Lo20xl/magnetide/design/v21-fusion/cube_front.png

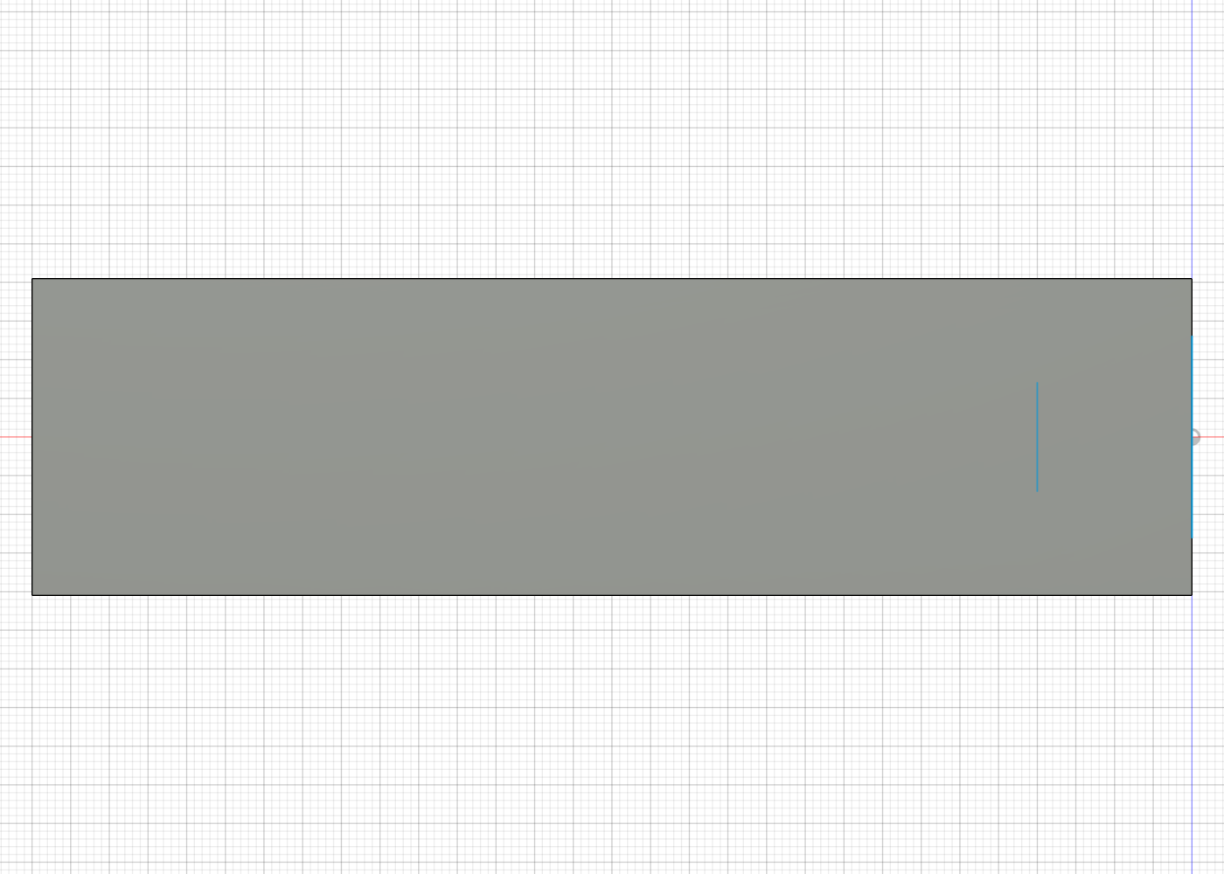
design/v21-fusion/cube_front.png
