Lo20xl/magnetide/design/v21-fusion/cube_iso.png

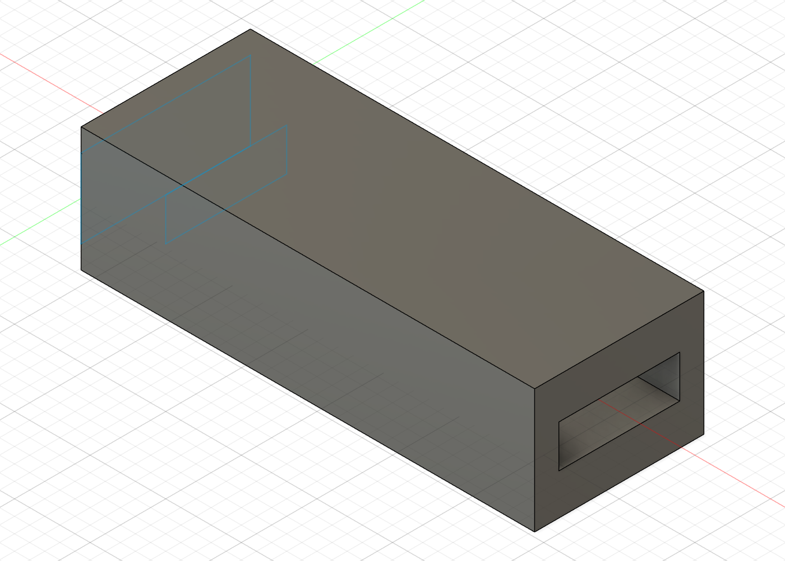
design/v21-fusion/cube_iso.png
