Lo20xl/magnetide/design/v21-fusion/iso_ur_clean.png

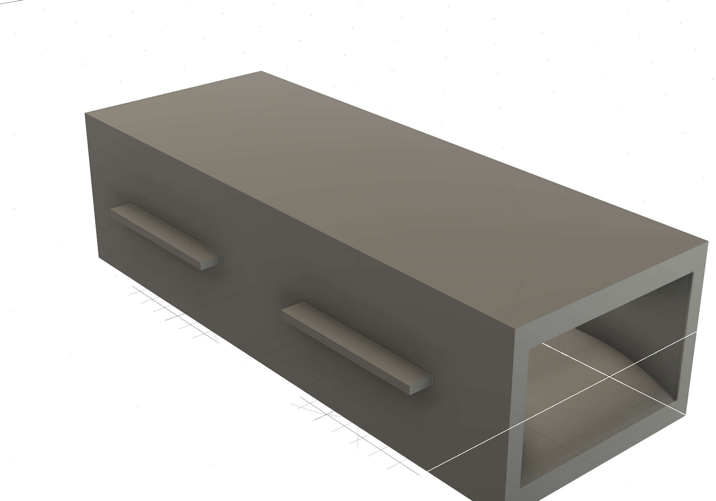
design/v21-fusion/iso_ur_clean.png
