Lo20xl/magnetide/design/v21-fusion/v3_front.png

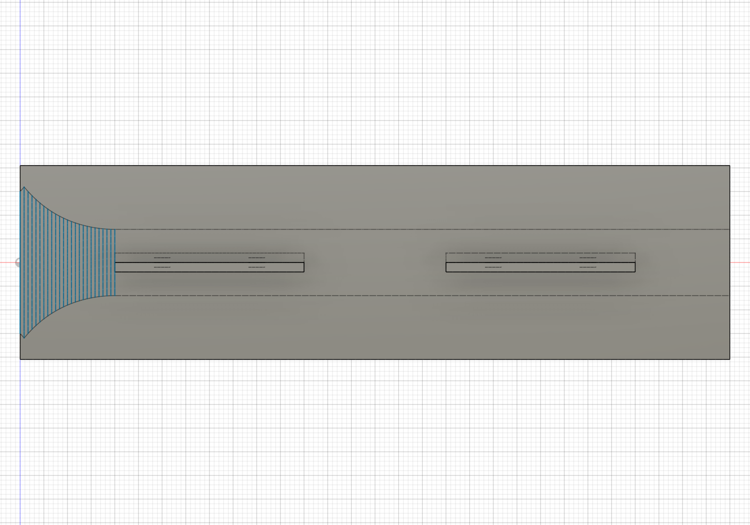
design/v21-fusion/v3_front.png
