Lo20xl/magnetide/design/v21-fusion/v3_iso.png

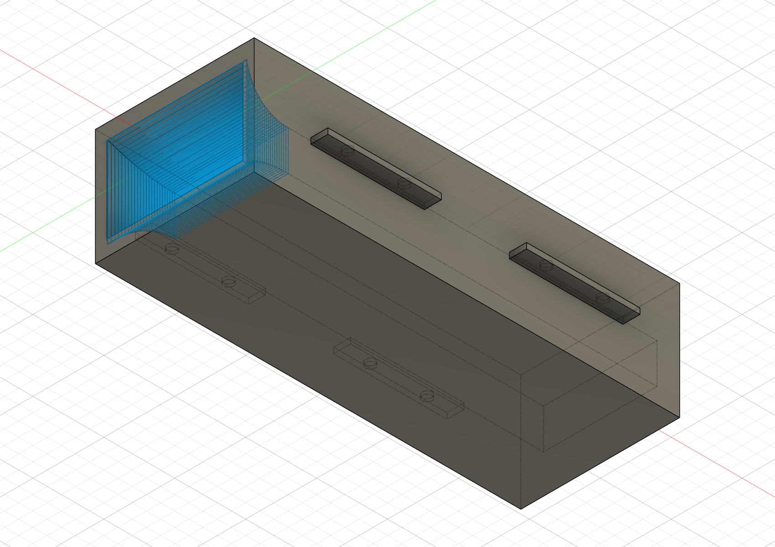
design/v21-fusion/v3_iso.png
