Lo20xl/magnetide/design/v21-fusion/v3_top.png

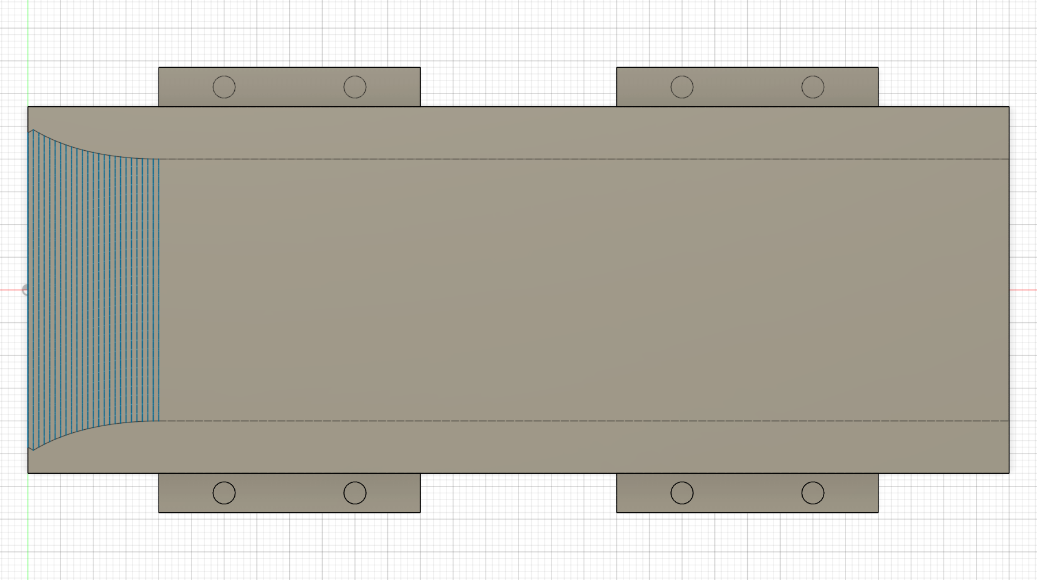
design/v21-fusion/v3_top.png
