Lo20xl/magnetide/design/v21r2/Magnetide-v21r2-crosssection.png

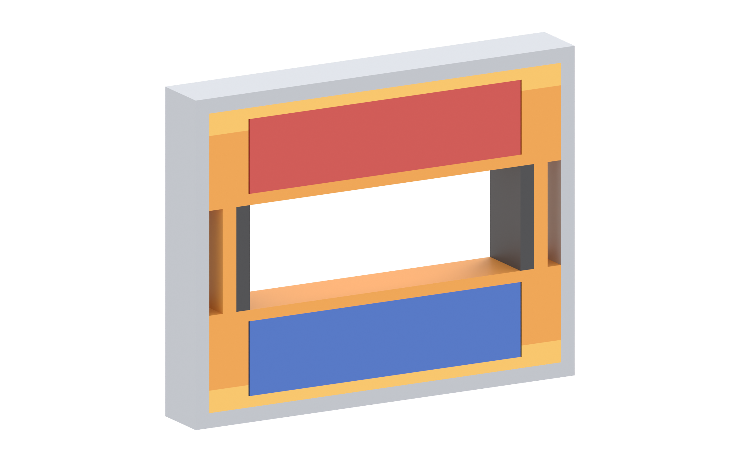
design/v21r2/Magnetide-v21r2-crosssection.png
