Lo20xl/magnetide/design/v21r2/view_r2e_section.png

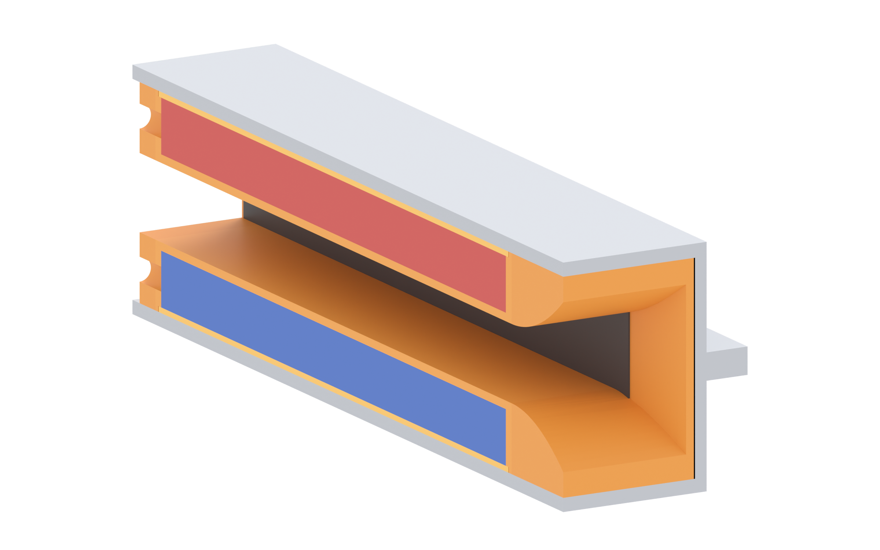
design/v21r2/view_r2e_section.png
