Lo20xl/magnetide/design/v25/v25_closed.png

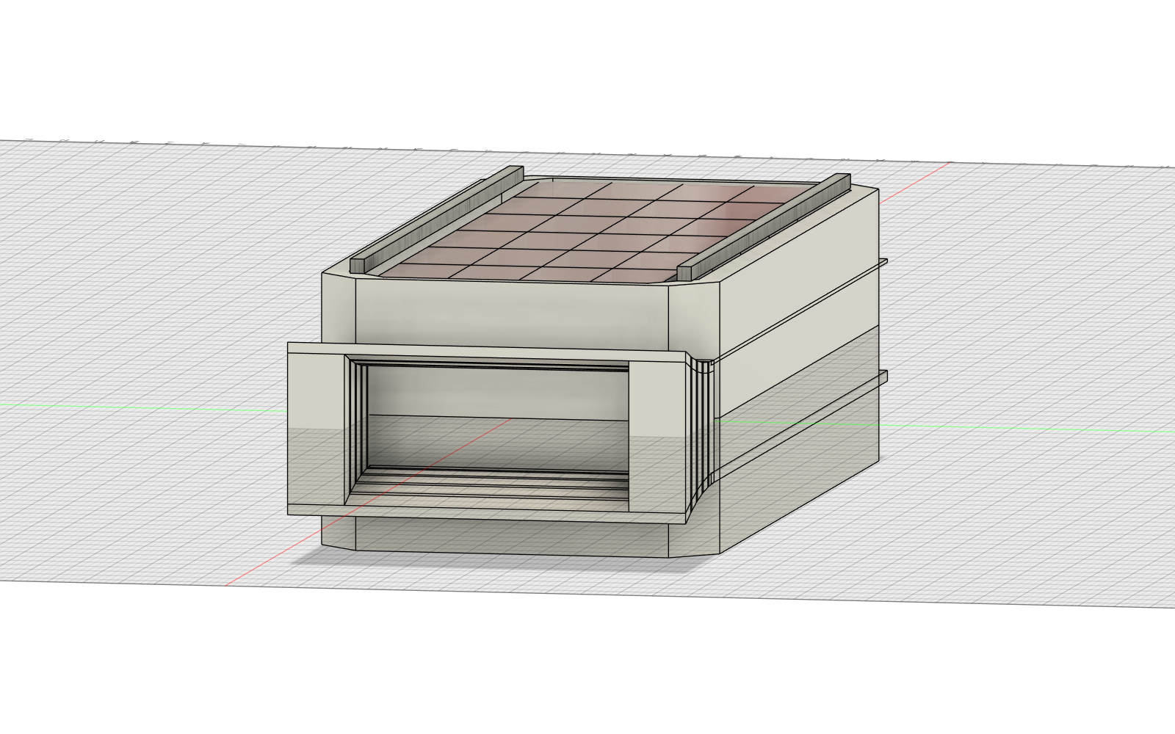
design/v25/v25_closed.png
