Lo20xl/magnetide/design/v25/v25_open.png

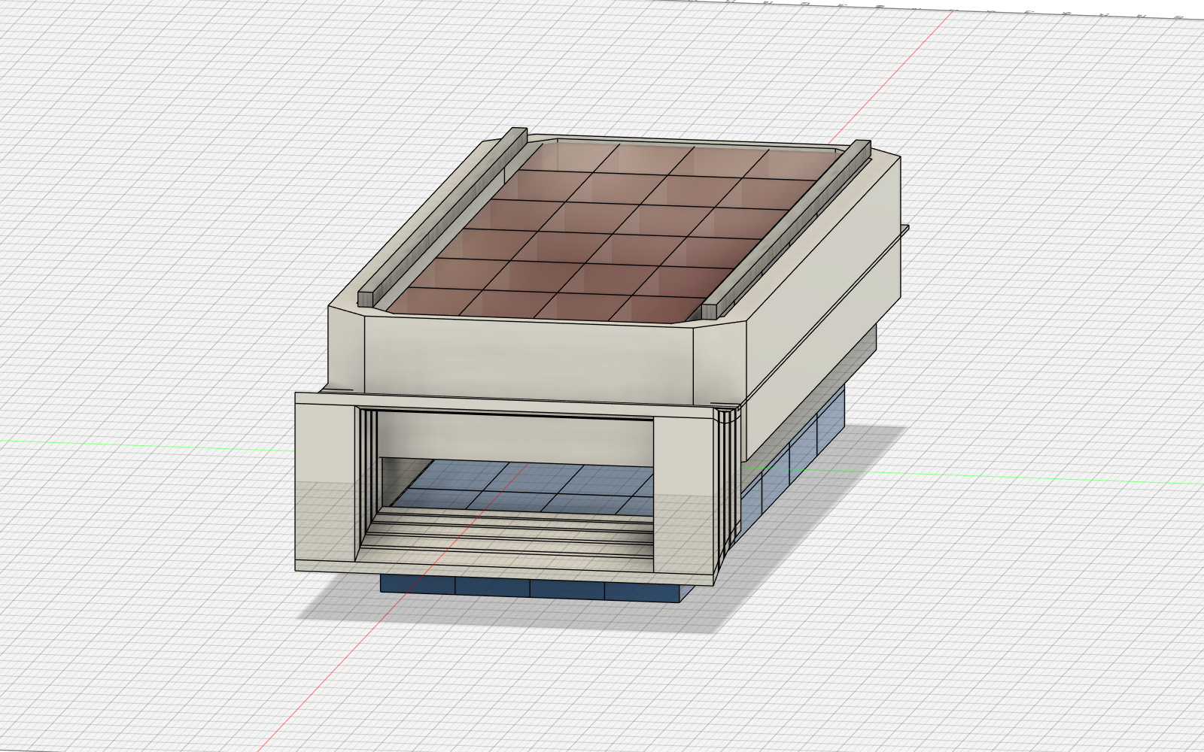
design/v25/v25_open.png
