Lo20xl/magnetide/design/v21-assembly/Magnetide-v21-assembly.step

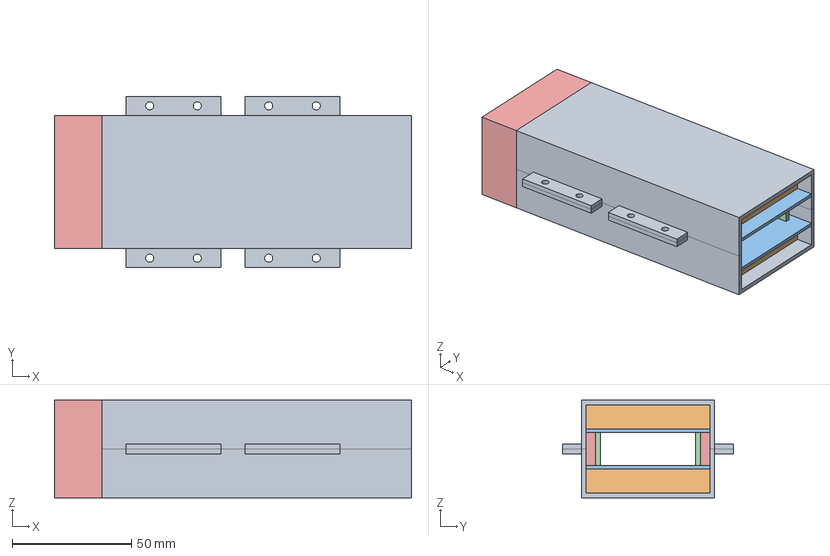
[picture p16: CAD file, 2026-10-23]
design/v21-assembly/Magnetide-v21-assembly.step
150.0 x 72.0 x 41.0 mm
