Lo20xl/magnetide/design/v21r2/release-r2h/Magnetide-v21r2h-assembly.step

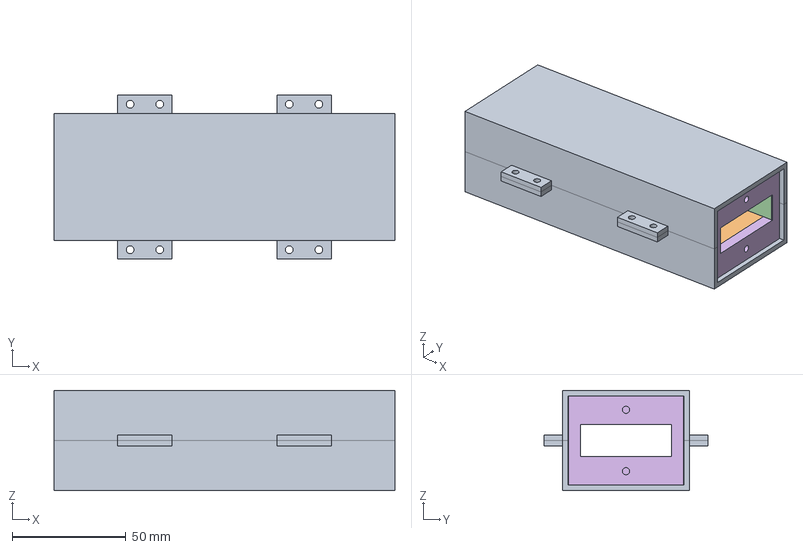
[picture p18: CAD file, 2026-10-23]
design/v21r2/release-r2h/Magnetide-v21r2h-assembly.step
150.0 x 72.0 x 44.0 mm
Steel_Top
Steel_Bottom
Tray_Top
Tray_Bottom
Cap_Top
Cap_Bottom
Electrode_P
Electrode_N
Bellmouth
Rear_Block
MAG_N_0
MAG_N_1
MAG_N_2
MAG_N_3
MAG_S_0
MAG_S_1
MAG_S_2
MAG_S_3
