Lo20xl/magnetide/cfd/case/constant/triSurface/flow.stl

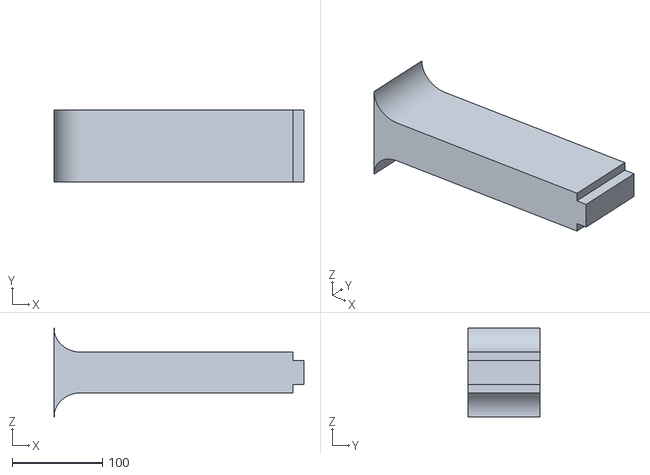
[picture p20: CAD file, 2026-10-20]
cfd/case/constant/triSurface/flow.stl
277.2 x 80.0 x 98.4
