Lo20xl/magnetide/design/v21-assembly/metal/clamshell-flat.dxf

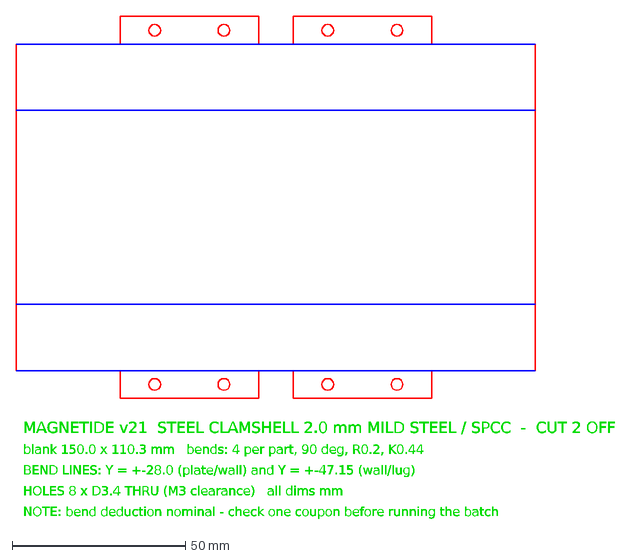
[picture p21: CAD file, 2026-10-23]
design/v21-assembly/metal/clamshell-flat.dxf
MAGNETIDE v21 STEEL CLAMSHELL 2.0 mm MILD STEEL / SPCC - CUT 2 OFF
blank 150.0 x 110.3 mm bends: 4 per part, 90 deg, R0.2, K0.44
BEND LINES: Y = +-28.0 (plate/wall) and Y = +-47.15 (wall/lug)
HOLES 8 x D3.4 THRU (M3 clearance) all dims mm
NOTE: bend deduction nominal - check one coupon before running the batch
