Lo20xl/magnetide/design/v21-assembly/plastic/tray.stl

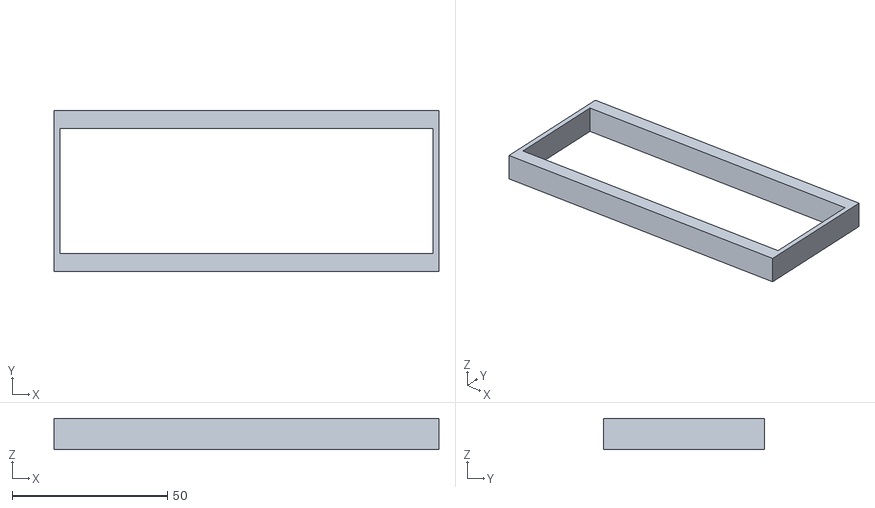
[picture p22: CAD file, 2026-10-23]
design/v21-assembly/plastic/tray.stl
124.0 x 52.0 x 10.0
