Lo20xl/magnetide/design/v21-stl/design-a/printable/rail_right.stl

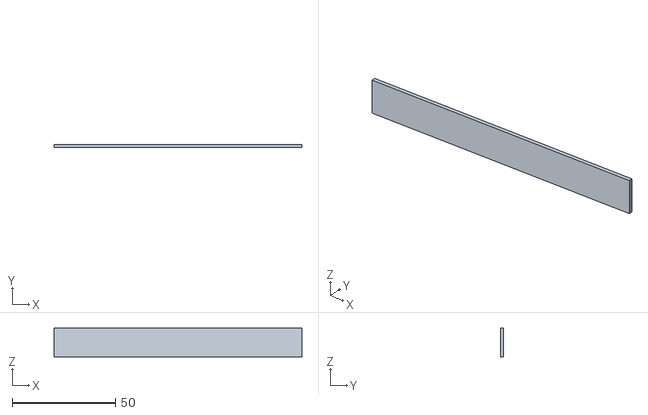
[picture p23: CAD file, 2026-10-21]
design/v21-stl/design-a/printable/rail_right.stl
120.0 x 1.60 x 14.0
