Lo20xl/magnetide/design/v21-stl/design-b/printable/front_flange.stl

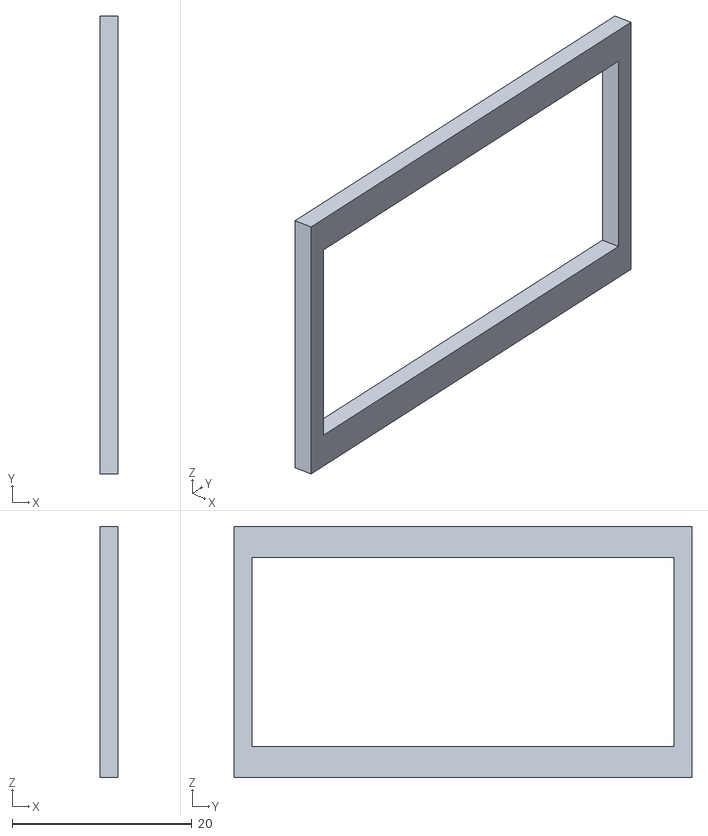
[picture p24: CAD file, 2026-10-21]
design/v21-stl/design-b/printable/front_flange.stl
2.00 x 51.0 x 28.0
