Lo20xl/magnetide/design/v21r2/metal/clamshell-flat-2.5mm.dxf

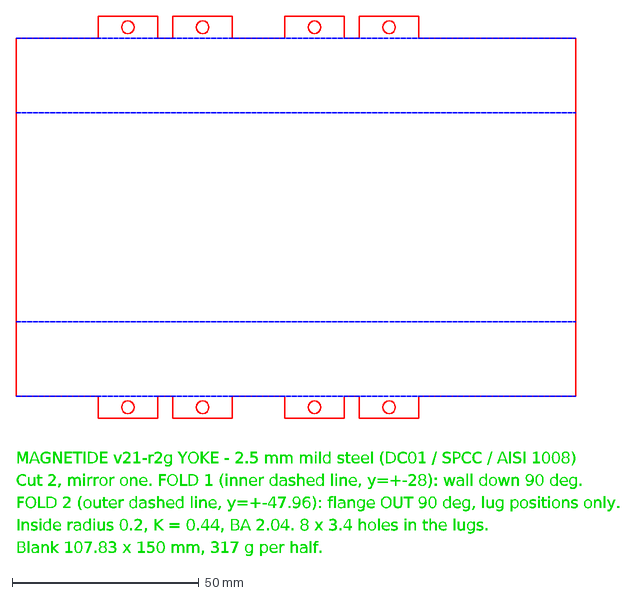
[picture p25: CAD file, 2026-10-23]
design/v21r2/metal/clamshell-flat-2.5mm.dxf
MAGNETIDE v21-r2g YOKE - 2.5 mm mild steel (DC01 / SPCC / AISI 1008)
Cut 2, mirror one. FOLD 1 (inner dashed line, y=+-28): wall down 90 deg.
FOLD 2 (outer dashed line, y=+-47.96): flange OUT 90 deg, lug positions only.
Inside radius 0.2, K = 0.44, BA 2.04. 8 x 3.4 holes in the lugs.
Blank 107.83 x 150 mm, 317 g per half.
