Lo20xl/magnetide/design/v21r2/release-r2h/laser/clamshell-flat-2.5mm.dxf

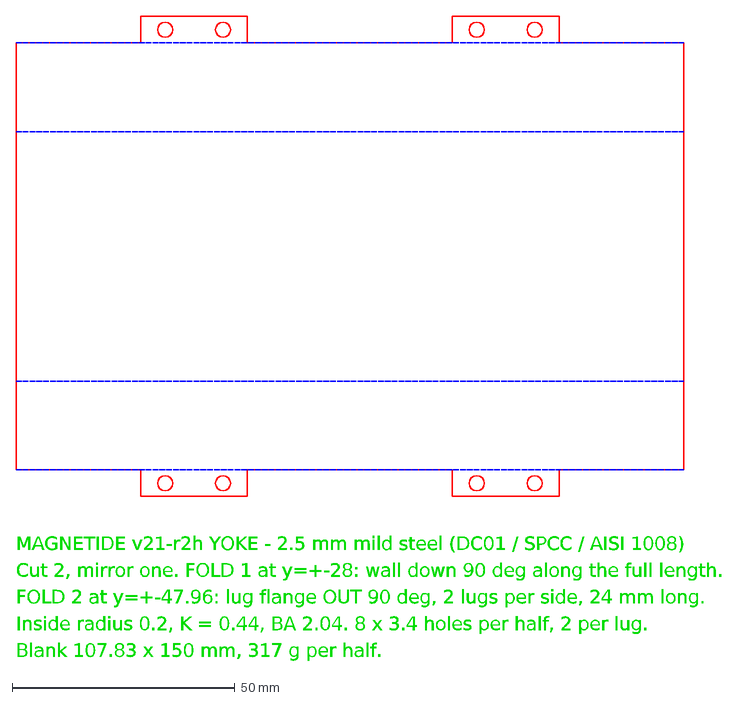
[picture p26: CAD file, 2026-10-23]
design/v21r2/release-r2h/laser/clamshell-flat-2.5mm.dxf
MAGNETIDE v21-r2h YOKE - 2.5 mm mild steel (DC01 / SPCC / AISI 1008)
Cut 2, mirror one. FOLD 1 at y=+-28: wall down 90 deg along the full length.
FOLD 2 at y=+-47.96: lug flange OUT 90 deg, 2 lugs per side, 24 mm long.
Inside radius 0.2, K = 0.44, BA 2.04. 8 x 3.4 holes per half, 2 per lug.
Blank 107.83 x 150 mm, 317 g per half.
