Lo20xl/magnetide/design/v21r2/release-r2h/print/bellmouth.stl

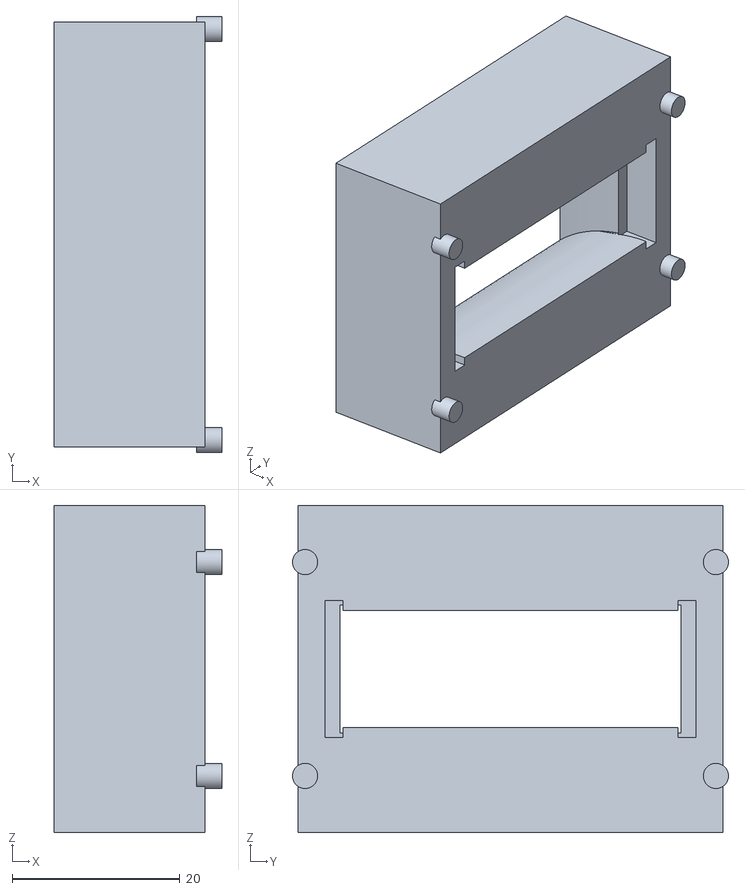
[picture p27: CAD file, 2026-10-23]
design/v21r2/release-r2h/print/bellmouth.stl
20.0 x 52.0 x 39.0
