Lo20xl/magnetide/design/v21r2/release-r2i/laser/clamshell-flat-3.0mm.dxf

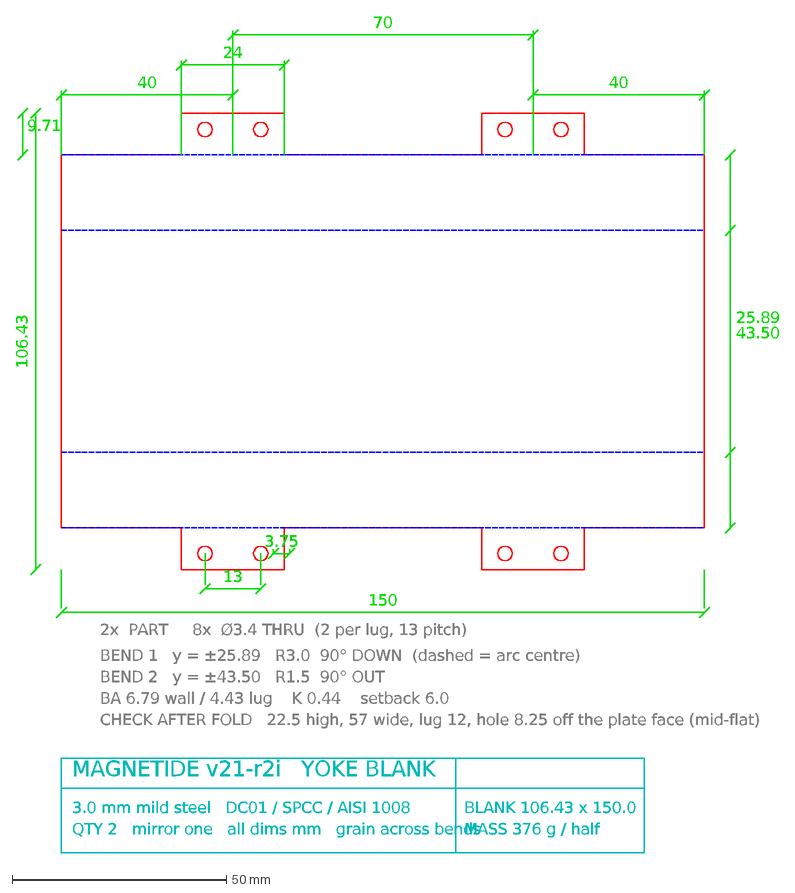
[picture p28: CAD file, 2026-10-24]
design/v21r2/release-r2i/laser/clamshell-flat-3.0mm.dxf
150
13
3.75
43.50
25.89
106.43
40
24
70
9.71
2x PART 8x Ø3.4 THRU (2 per lug, 13 pitch)
BEND 1 y = ±25.89 R3.0 90° DOWN (dashed = arc centre)
BEND 2 y = ±43.50 R1.5 90° OUT
BA 6.79 wall / 4.43 lug K 0.44 setback 6.0
CHECK AFTER FOLD 22.5 high, 57 wide, lug 12, hole 8.25 off the plate face (mid-flat)
MAGNETIDE v21-r2i YOKE BLANK
3.0 mm mild steel DC01 / SPCC / AISI 1008
QTY 2 mirror one all dims mm grain across bends
BLANK 106.43 x 150.0
MASS 376 g / half
