Lo20xl/magnetide/design/v21r2/release-r2i/print/cap.stl

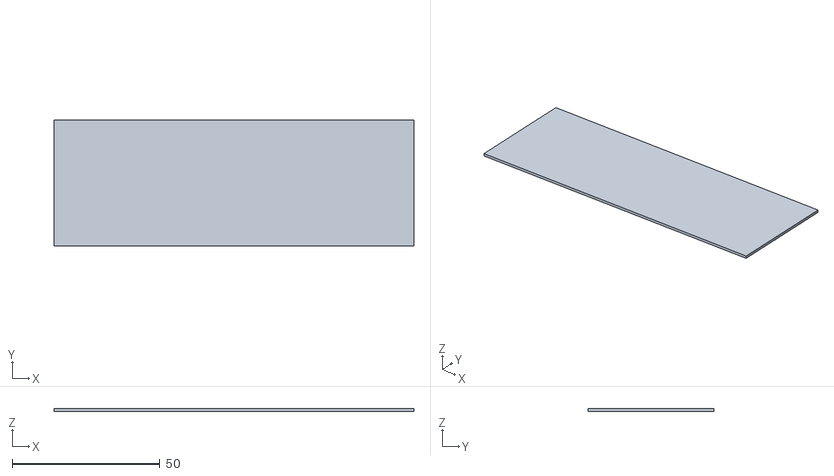
[picture p29: CAD file, 2026-10-24]
design/v21r2/release-r2i/print/cap.stl
121.7 x 42.7 x 1.00
