Lo20xl/magnetide/design/v21r2/release-r2i/yoke-steel-top.step

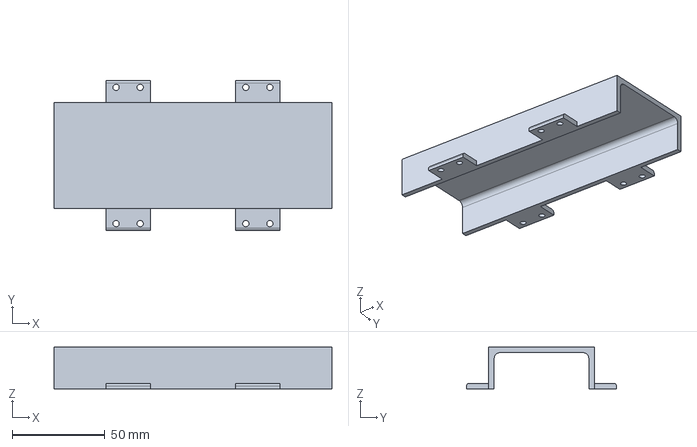
[picture p30: CAD file, 2026-10-24]
design/v21r2/release-r2i/yoke-steel-top.step
150.0 x 81.0 x 22.5 mm
