Lo20xl/magnetide/stl/nozzle_plate_mild_56x27.stl

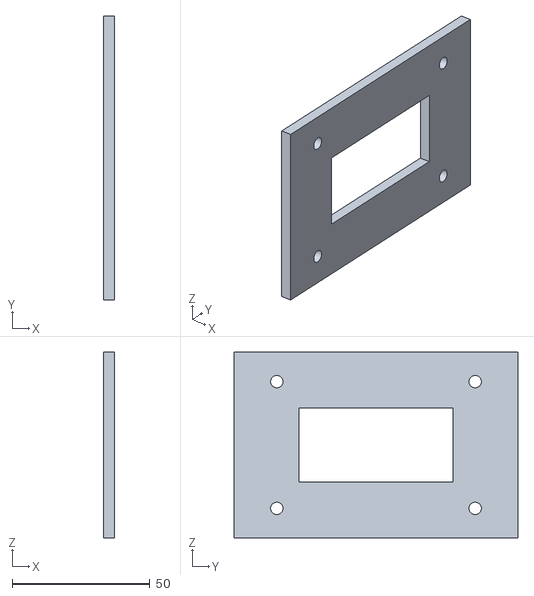
[picture p31: CAD file, 2026-10-20]
stl/nozzle_plate_mild_56x27.stl
4.00 x 103.0 x 67.5
