Lo20xl/magnetide/design/v21-assembly/plastic/liner_top.stl

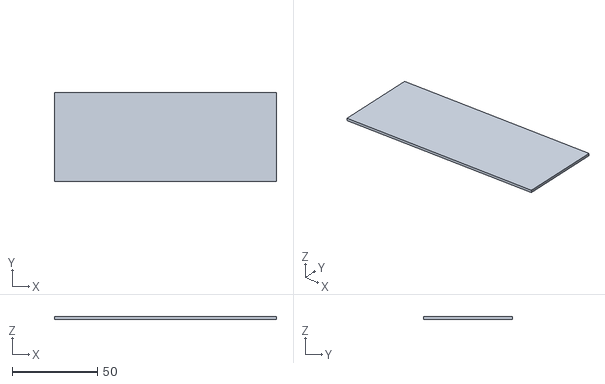
[picture p32: CAD file, 2026-10-23]
design/v21-assembly/plastic/liner_top.stl
130.0 x 52.0 x 1.50
