Lo20xl/magnetide/design/v21-stl/design-b/printable/fairing_bottom.stl

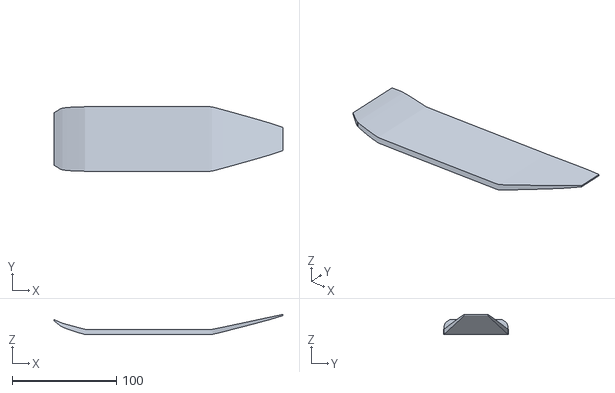
[picture p33: CAD file, 2026-10-21]
design/v21-stl/design-b/printable/fairing_bottom.stl
220.0 x 62.0 x 19.5
