Lo20xl/magnetide/design/v21r2/metal/clamshell-flat.dxf

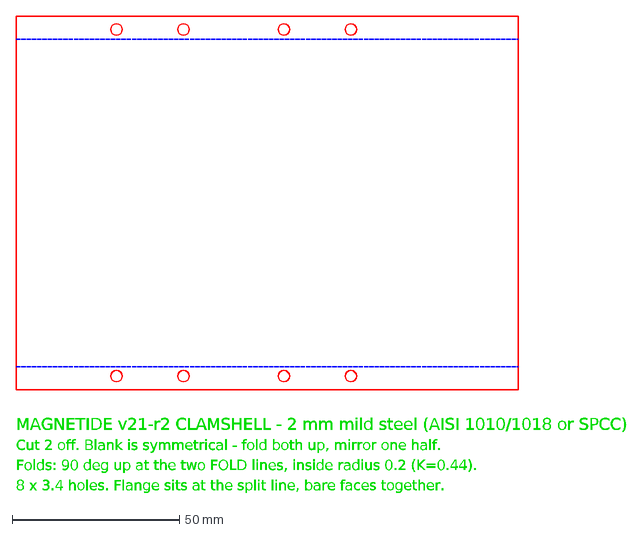
[picture p34: CAD file, 2026-10-23]
design/v21r2/metal/clamshell-flat.dxf
MAGNETIDE v21-r2 CLAMSHELL - 2 mm mild steel (AISI 1010/1018 or SPCC)
Cut 2 off. Blank is symmetrical - fold both up, mirror one half.
Folds: 90 deg up at the two FOLD lines, inside radius 0.2 (K=0.44).
8 x 3.4 holes. Flange sits at the split line, bare faces together.
