Lo20xl/magnetide/design/v21r2/release-r2h/print/rear_block.stl

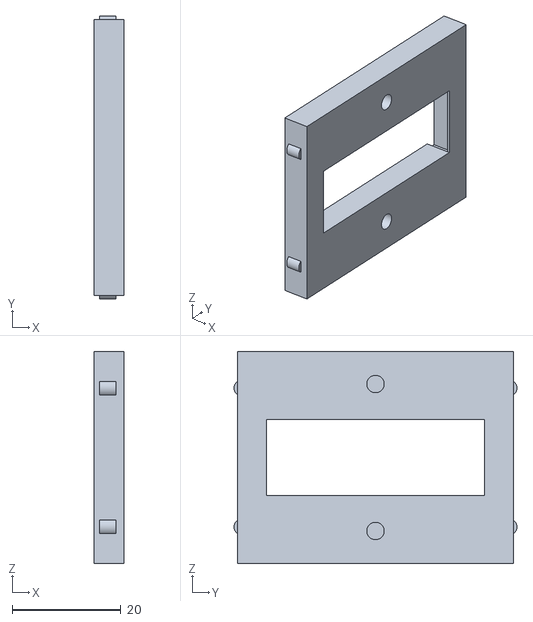
[picture p35: CAD file, 2026-10-23]
design/v21r2/release-r2h/print/rear_block.stl
5.50 x 52.0 x 39.0
