Lo20xl/magnetide/design/v21r2/release-r2i/print/tray.stl

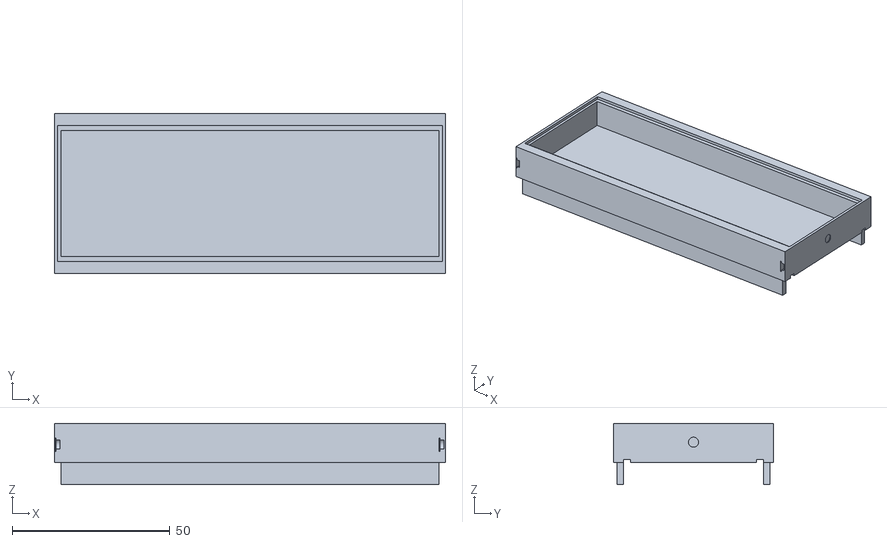
[picture p36: CAD file, 2026-10-24]
design/v21r2/release-r2i/print/tray.stl
124.0 x 50.7 x 19.5
