Lo20xl/magnetide/stl/inlet_cheek_right.stl

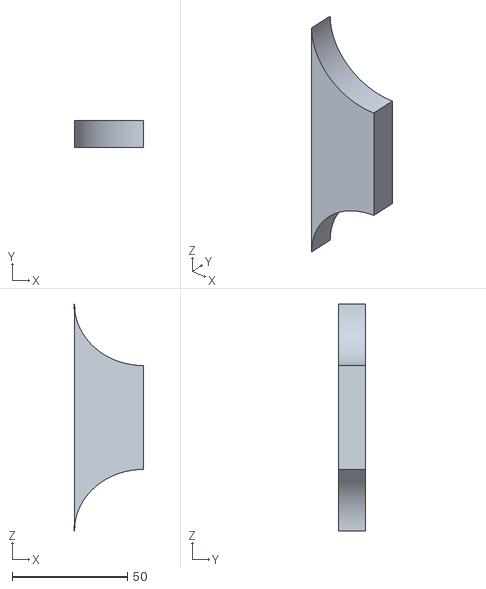
[picture p37: CAD file, 2026-10-20]
stl/inlet_cheek_right.stl
30.0 x 11.5 x 98.4
