Lo20xl/magnetide/design/v21-stl/design-b/printable/plate_b.stl

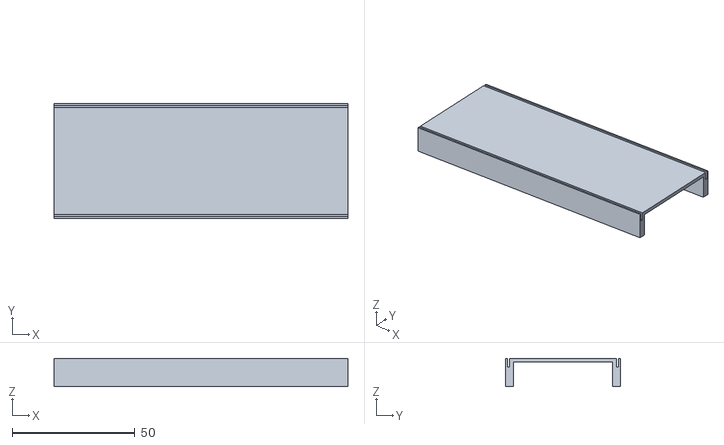
[picture p38: CAD file, 2026-10-21]
design/v21-stl/design-b/printable/plate_b.stl
120.0 x 47.0 x 11.5
