Lo20xl/magnetide/design/v21r2/release-r2i/print/rear_block.stl

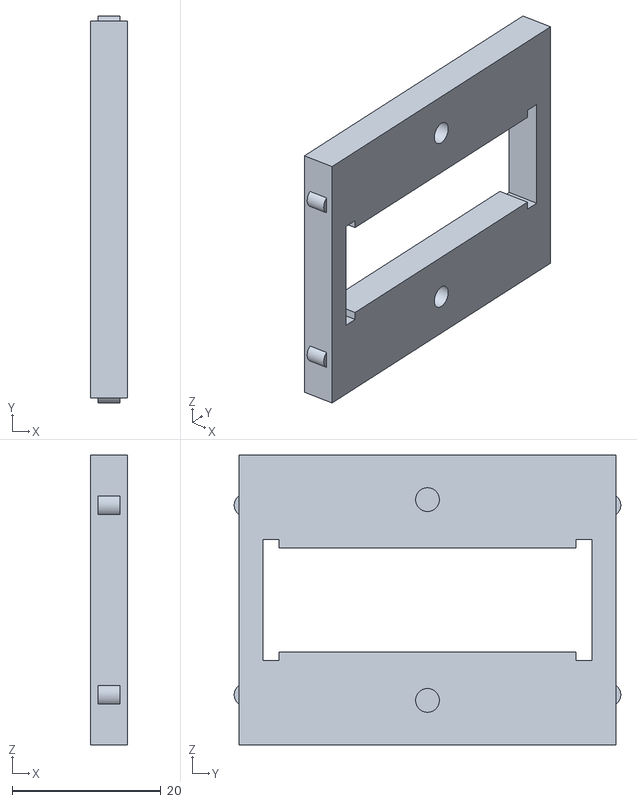
[picture p39: CAD file, 2026-10-24]
design/v21r2/release-r2i/print/rear_block.stl
5.00 x 52.0 x 39.0
