Lo20xl/magnetide/stl/lead_gland_right.stl

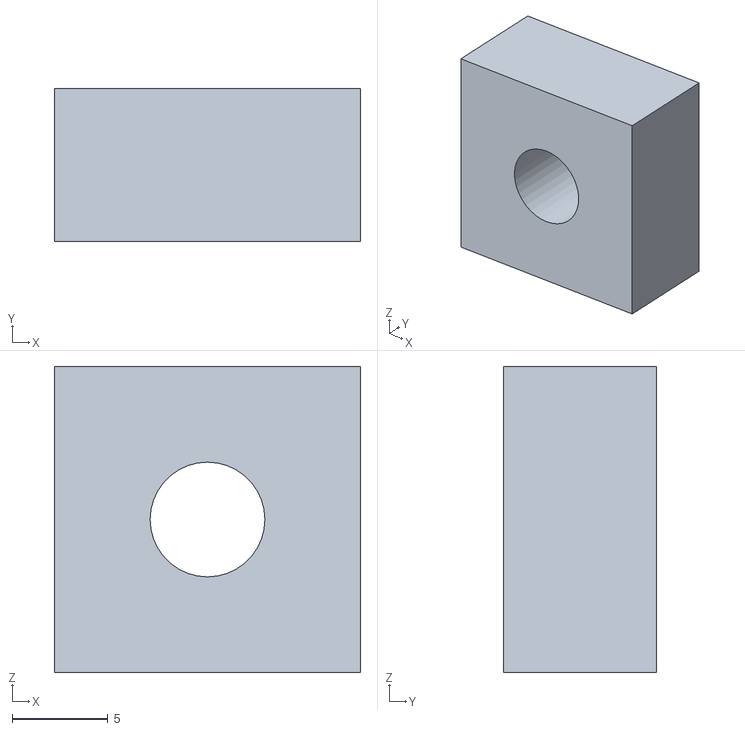
[picture p40: CAD file, 2026-10-20]
stl/lead_gland_right.stl
16.0 x 8.00 x 16.0
