Lo20xl/magnetide/design/v21-assembly/plastic/bellmouth.stl

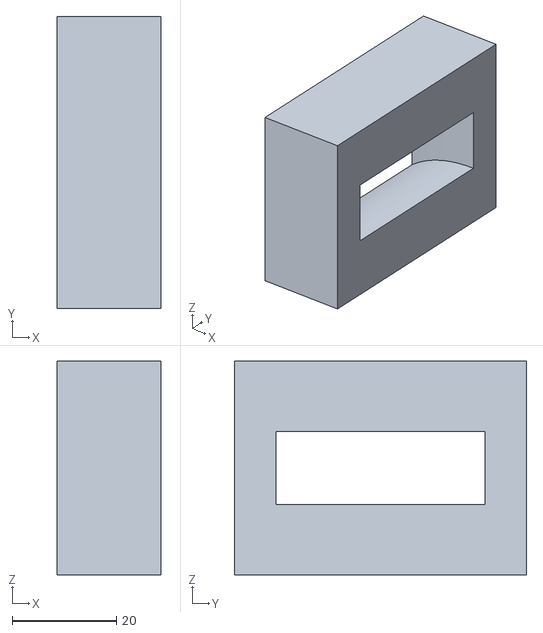
[picture p41: CAD file, 2026-10-23]
design/v21-assembly/plastic/bellmouth.stl
20.0 x 56.0 x 41.0
