Lo20xl/magnetide/design/v21-stl/design-b/printable/bellmouth_top.stl

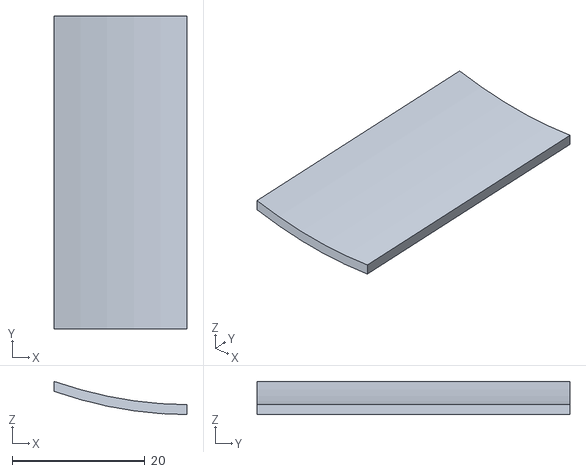
[picture p42: CAD file, 2026-10-21]
design/v21-stl/design-b/printable/bellmouth_top.stl
20.0 x 47.0 x 5.00
