Lo20xl/magnetide/design/v21r2/plastic/bellmouth.stl

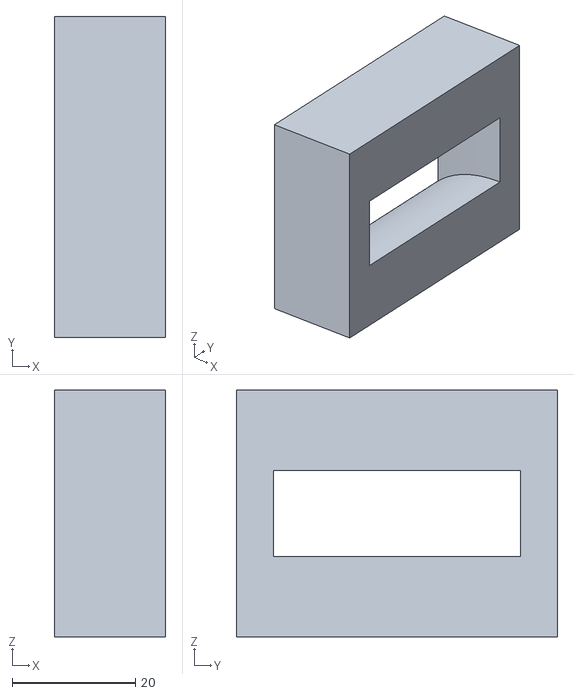
[picture p43: CAD file, 2026-10-23]
design/v21r2/plastic/bellmouth.stl
18.0 x 52.0 x 40.0
