Lo20xl/magnetide/stl/magnet_tray_top_rim.stl

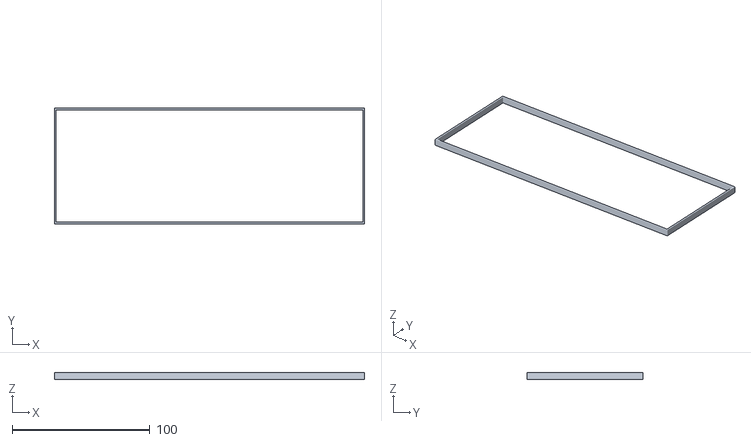
[picture p44: CAD file, 2026-10-20]
stl/magnet_tray_top_rim.stl
225.2 x 84.0 x 5.05
