Lo20xl/magnetide/design/v21-stl/design-b/printable/rear_cap.stl

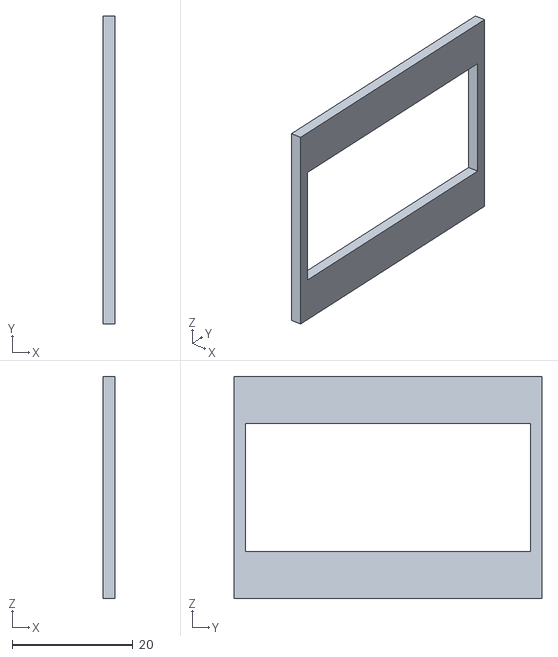
[picture p45: CAD file, 2026-10-21]
design/v21-stl/design-b/printable/rear_cap.stl
2.00 x 51.0 x 36.8
