Lo20xl/magnetide/stl/housing_shell_side_left_aft.stl

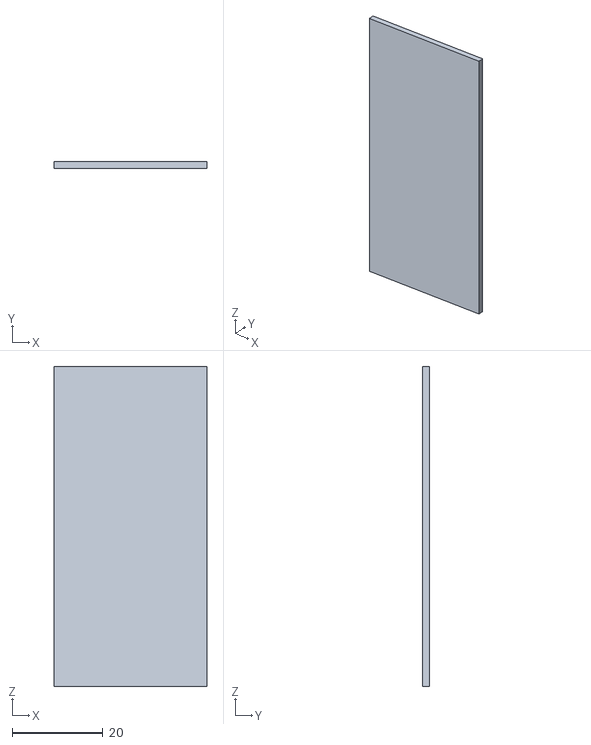
[picture p46: CAD file, 2026-10-20]
stl/housing_shell_side_left_aft.stl
33.6 x 1.50 x 70.5
