Lo20xl/magnetide/design/v21-stl/design-b/printable/bellmouth_right.stl

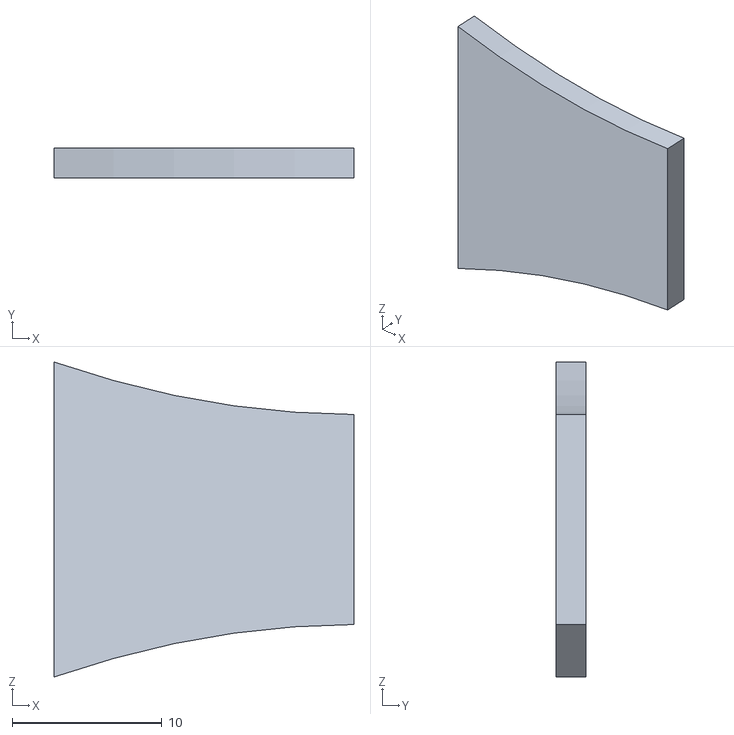
[picture p47: CAD file, 2026-10-21]
design/v21-stl/design-b/printable/bellmouth_right.stl
20.0 x 2.00 x 21.0
