Lo20xl/magnetide/stl/housing_shell_side_right_under.stl

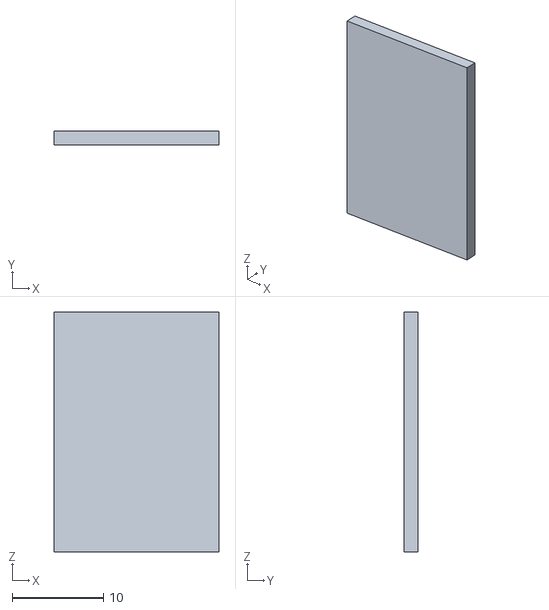
[picture p48: CAD file, 2026-10-20]
stl/housing_shell_side_right_under.stl
18.0 x 1.50 x 26.2
