Lo20xl/magnetide/stl/inlet_flare_top.stl

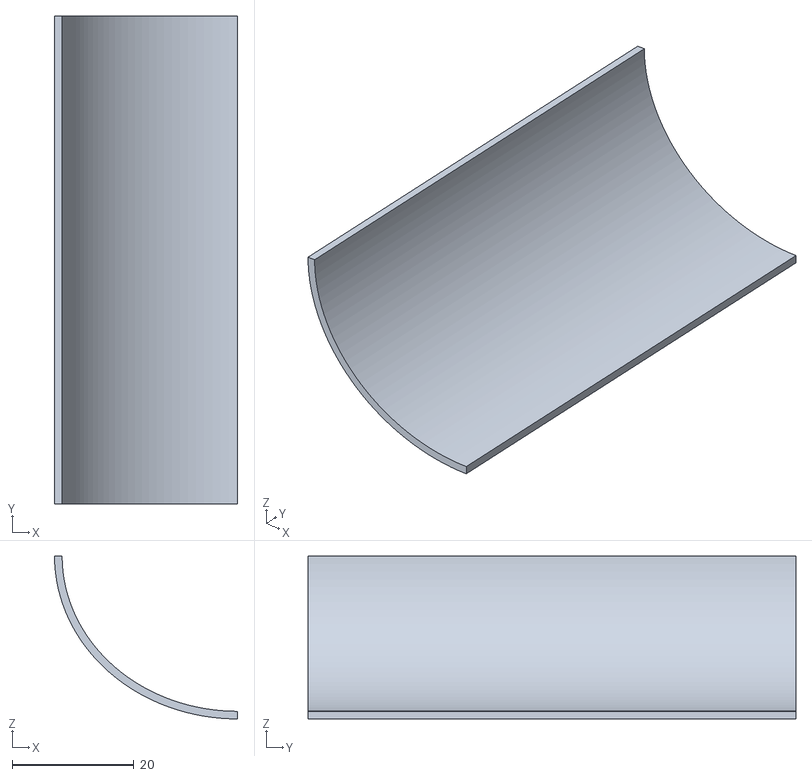
[picture p49: CAD file, 2026-10-20]
stl/inlet_flare_top.stl
30.0 x 80.0 x 26.7
