Lo20xl/magnetide/design/v21-stl/design-b/printable/fair_tail_bulkhead.stl

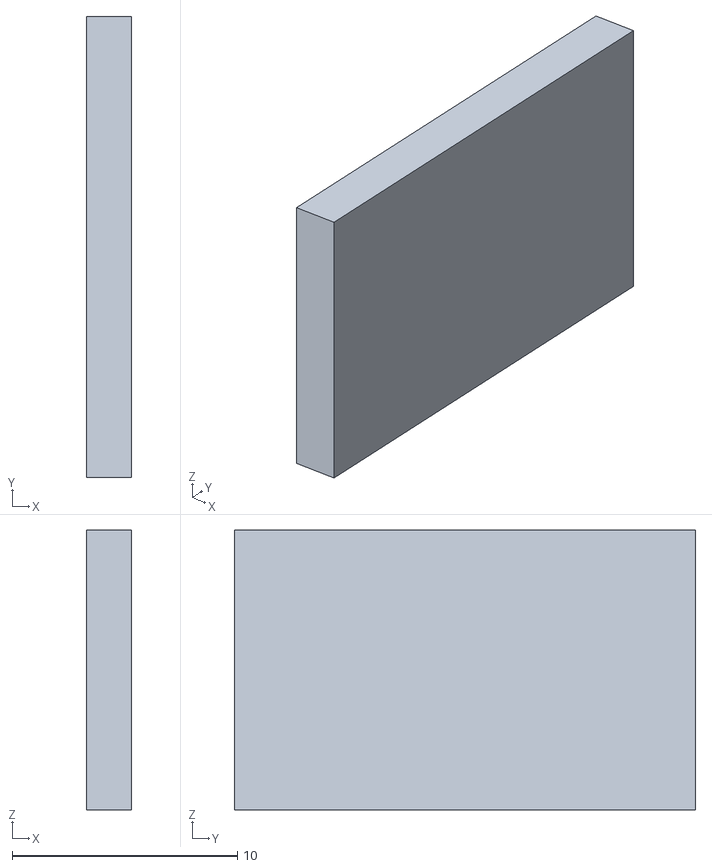
[picture p50: CAD file, 2026-10-21]
design/v21-stl/design-b/printable/fair_tail_bulkhead.stl
2.00 x 20.5 x 12.4
