Lo20xl/magnetide/stl/mount_flange_inlet.stl

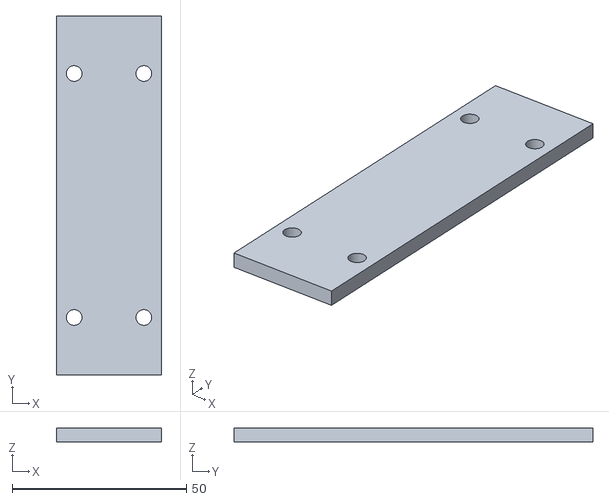
[picture p51: CAD file, 2026-10-20]
stl/mount_flange_inlet.stl
30.0 x 103.0 x 4.00
