Lo20xl/magnetide/design/v21-stl/design-b/printable/fairing_left.stl

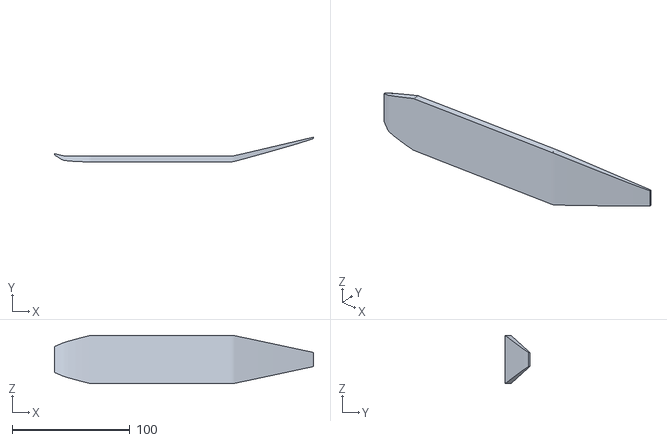
[picture p52: CAD file, 2026-10-21]
design/v21-stl/design-b/printable/fairing_left.stl
220.0 x 21.0 x 41.0
