Lo20xl/magnetide/stl/housing_shell_side_right_fwd.stl

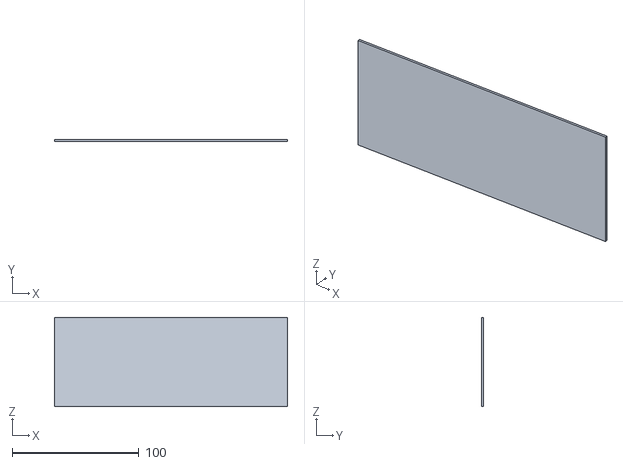
[picture p53: CAD file, 2026-10-20]
stl/housing_shell_side_right_fwd.stl
183.6 x 1.50 x 70.5
