Lo20xl/magnetide/stl/housing_shell_top_mid.stl

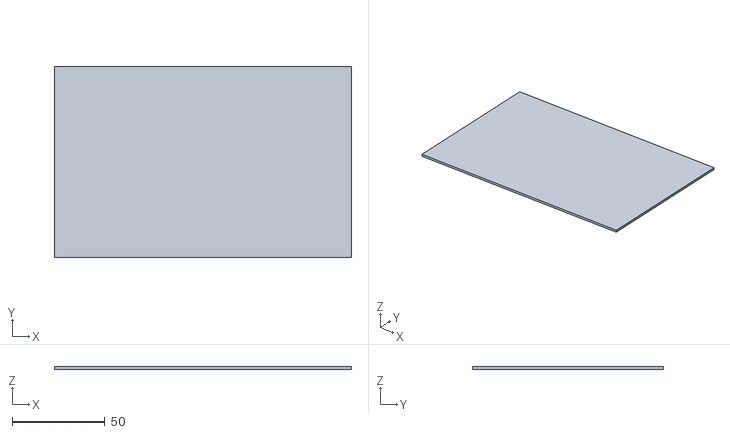
[picture p54: CAD file, 2026-10-20]
stl/housing_shell_top_mid.stl
160.0 x 103.0 x 1.50
