Lo20xl/magnetide/design/v21-stl/design-b/printable/fair_nose_bulkhead.stl

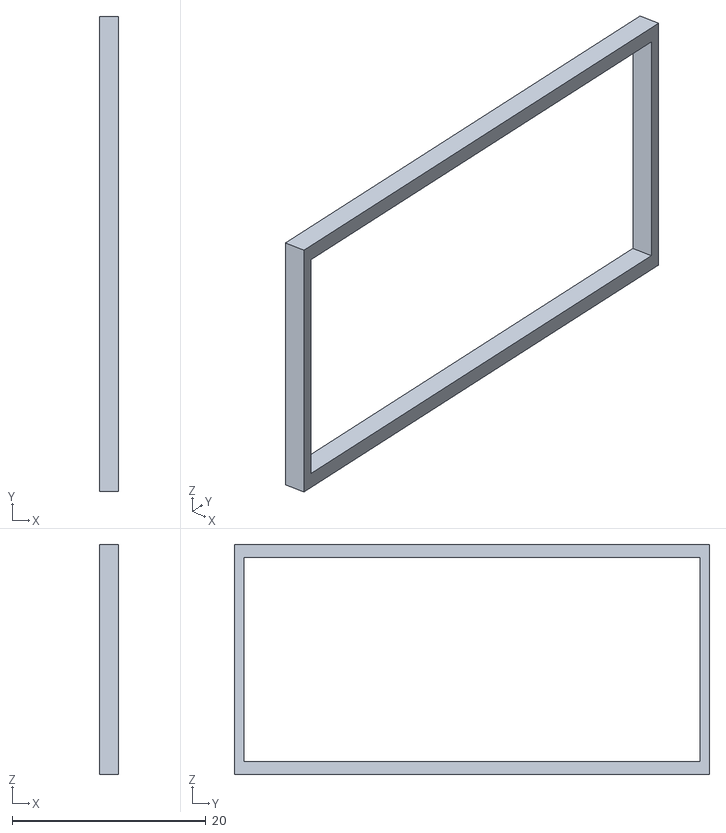
[picture p55: CAD file, 2026-10-21]
design/v21-stl/design-b/printable/fair_nose_bulkhead.stl
2.00 x 49.0 x 23.8
