Lo20xl/magnetide/stl/housing_shell_cap_outlet.stl

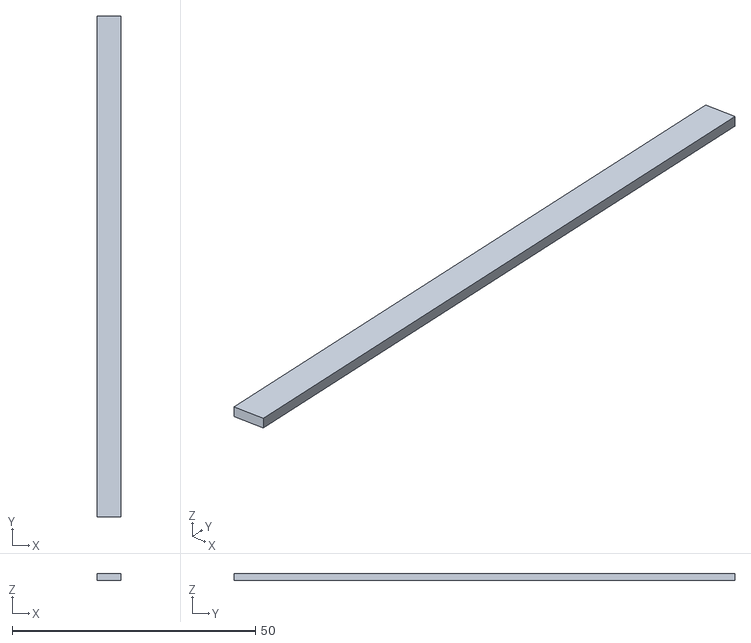
[picture p56: CAD file, 2026-10-20]
stl/housing_shell_cap_outlet.stl
5.00 x 103.0 x 1.50
