Lo20xl/magnetide/stl/magnet_tray_top_floor.stl

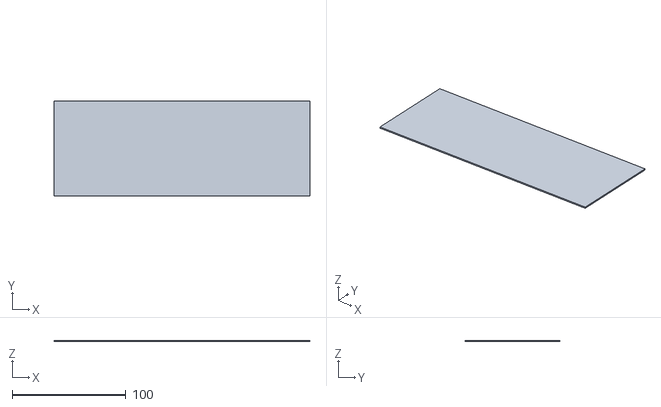
[picture p57: CAD file, 2026-10-20]
stl/magnet_tray_top_floor.stl
225.2 x 84.0 x 1.20
