Lo20xl/magnetide/(list of files, cad)

Other CAD files:
design/v21r2/Magnetide-v21r2e-assembly.step
design/v21r2/Magnetide-v21r2-assembly.step
design/v21r2/release-r2i/yoke-steel-bottom.step
design/v21-assembly/plastic/liner_bottom.stl
design/v21-stl/design-b/printable/rail_left.stl
design/v21-stl/design-b/printable/bellmouth_left.stl
stl/housing_shell_side_left_over.stl
design/v21-stl/design-b/printable/bellmouth_bottom.stl
stl/lead_gland_left.stl
design/v21-stl/design-b/printable/fairing_right.stl
design/v21-stl/design-b/printable/fairing_top.stl
stl/magnet_tray_bottom_rim.stl
design/v21-stl/design-b/printable/plate_a.stl
stl/inlet_cheek_left.stl
stl/housing_shell_cap_inlet.stl
stl/housing_shell_side_right_aft.stl
stl/housing_shell_side_left_fwd.stl
stl/mount_flange_outlet.stl
stl/inlet_flare_bottom.stl
stl/housing_shell_side_left_under.stl
stl/housing_shell_side_right_over.stl
stl/magnet_tray_bottom_floor.stl
design/v21-assembly/Magnetide-v21-EXPLODED.f3d
design/v21-assembly/Magnetide-v21-assembly.f3d
design/v21-fusion/Magnetide-v21-cube.f3d
design/v21-stl/design-a/Magnetide-A-full.f3d
design/v21-stl/design-a/Magnetide-A-printable.f3d
design/v21-stl/design-b/Magnetide-B-full.f3d
design/v21-stl/design-b/Magnetide-B-printable.f3d
design/v21r2/Magnetide-v21r2-EXPLODED.f3d
design/v21r2/Magnetide-v21r2-assembly.f3d
design/v21r2/Magnetide-v21r2e-EXPLODED.f3d
design/v21r2/Magnetide-v21r2e-assembly.f3d
design/v21r2/Magnetide-v21r2g-assembly.f3d
design/v21r2/plastic/cap.stl
design/v21r2/plastic/rear_block.stl
design/v21r2/plastic/tray.stl
design/v21r2/release-r2h/Magnetide-v21r2h-EXPLODED.f3d
design/v21r2/release-r2h/Magnetide-v21r2h-assembly.f3d
design/v22-casing.f3d
design/v23/Magnetide-v23-full.f3d
design/v23/graphite_L.stl
design/v23/graphite_R.stl
design/v23/half.stl
