Lo20xl/magnetide/design/v21-assembly/Magnetide-v21-exploded-fusion-below.png

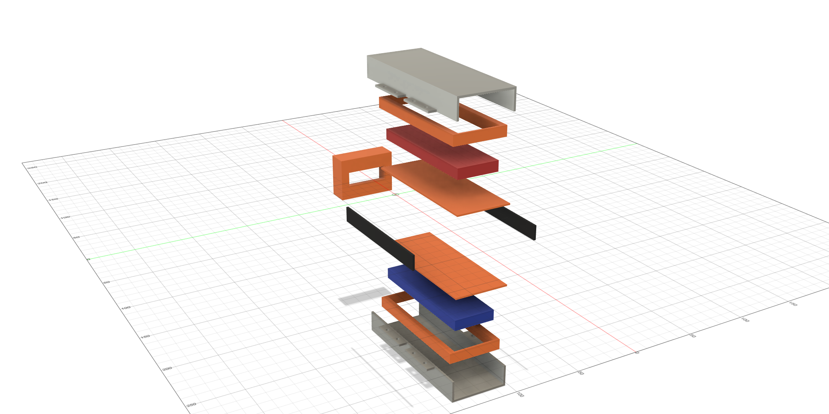
design/v21-assembly/Magnetide-v21-exploded-fusion-below.png
