Lo20xl/magnetide/design/v21-assembly/Magnetide-v21-exploded-view.png

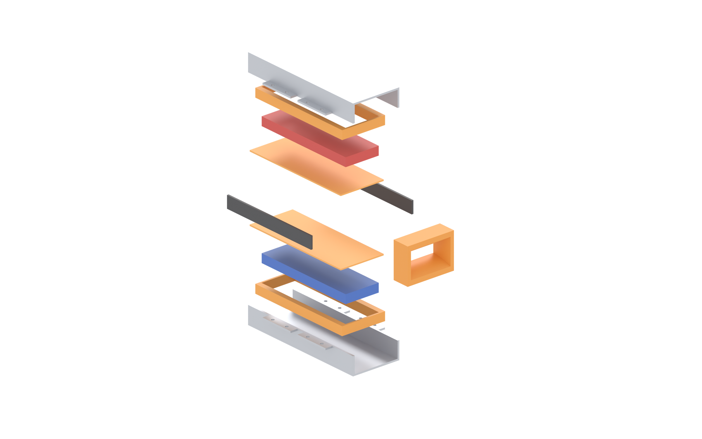
design/v21-assembly/Magnetide-v21-exploded-view.png
