Lo20xl/magnetide/design/v21-assembly/metal/clamshell-flat.png

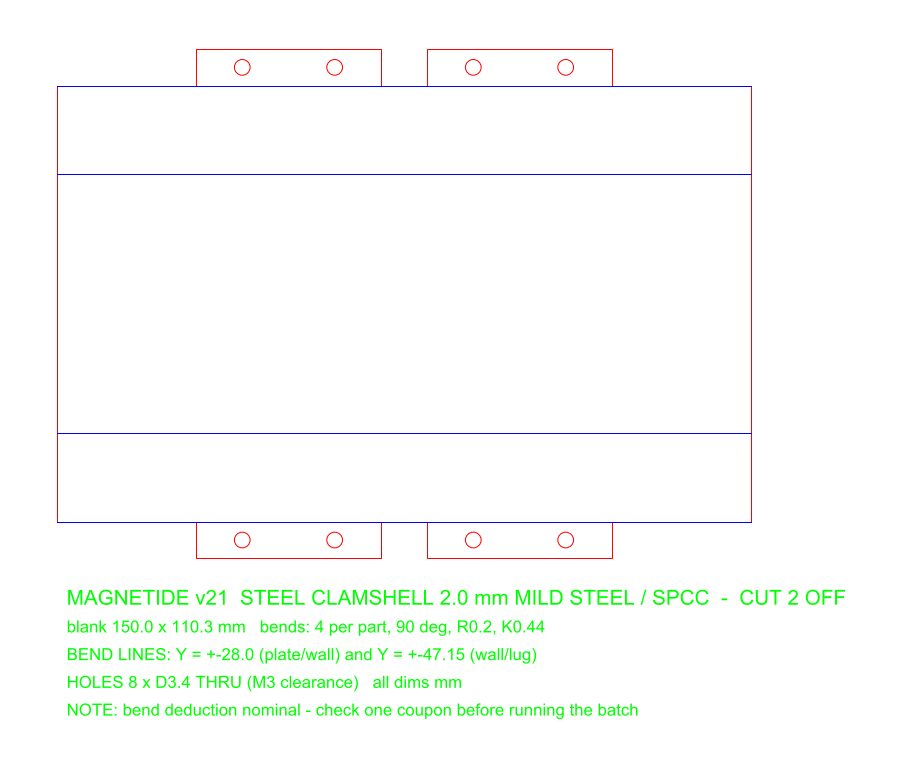
design/v21-assembly/metal/clamshell-flat.png
