Lo20xl/magnetide/design/v21-assembly/view_magnets.png

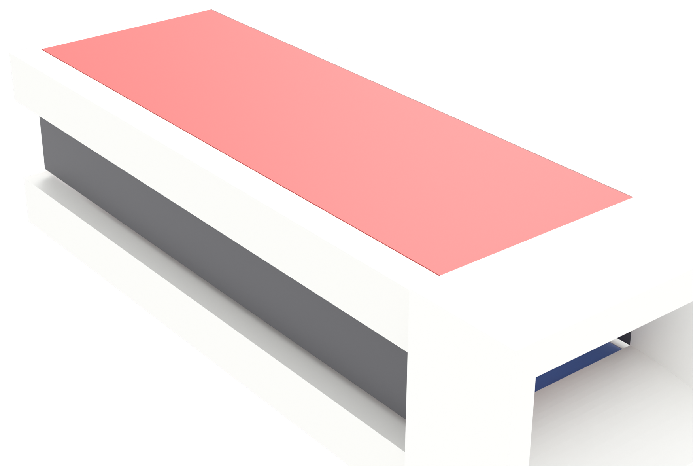
design/v21-assembly/view_magnets.png
