Lo20xl/magnetide/design/v21-assembly/view_rear.png

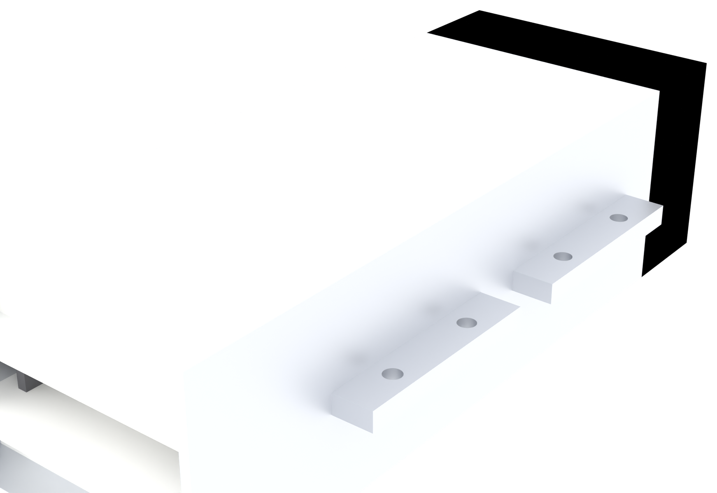
design/v21-assembly/view_rear.png
