Lo20xl/magnetide/design/v21r2/release-r2i/renders/view_r2i_assembled.png

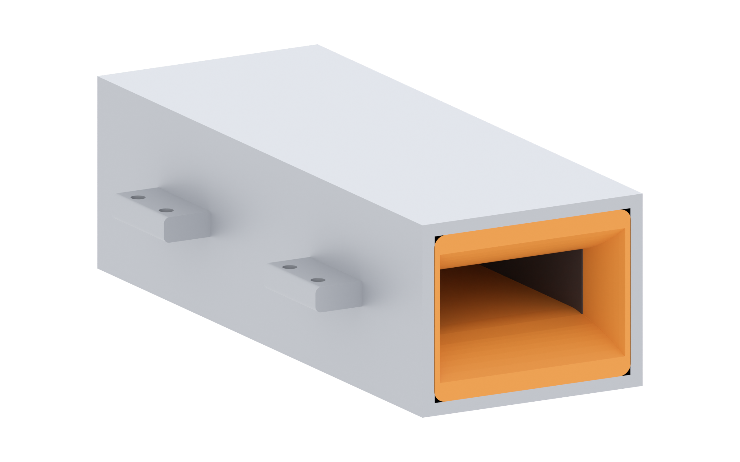
design/v21r2/release-r2i/renders/view_r2i_assembled.png
