Lo20xl/magnetide/design/v21r2/CHANGES-v21r2e.md

# v21-r2e

1. STEEL: one gauge, 2.5 mm. The old shell folded 2 mm walls onto a 3.5 mm
   top plate - not foldable from one sheet. Blank now 107.83 x 150 mm,
   BA 2.042 (K=0.44, R0.2), 317 g per half, uniform fold widths 19.96 / 5.96.
2. TRAY is a cavity. Magnet drops into it: 8.5 - 18.5 mm, floor under it,
   walls on all four sides, end walls close it in X.
3. CAP kept. 1.0 mm lid, sits on the magnet in a 1.0 mm ledge in the tray
   rim, top flush with the steel inner face. No air void under the cap.
4. ELECTRODE seat 0.6 -> 3.0 mm, slot 2.2 wide. Exposed height still 14 mm,
   so wetted area is unchanged at 1736 mm2 per electrode.
5. Electrode ends extend 5 mm into the bellmouth and rear block (the old
   "ear" was a 3 mm strip over a 3 mm end - it retained nothing).

Per half (z): 0-7 bore | 7-8.5 tray floor | 8.5-18.5 magnet | 18.5-19.5 cap
| 19.5-22 steel.  Sum 22 = H/2.
