Lo20xl/magnetide/(commit log)

2026-10-20 Magnetide: analytic screen model + CFD validation for a benchtop MHD pump
    A zero-dependency Python stdlib model and parametric sweep harness, an
    OpenFOAM case validating the hydraulics, and Blender-based STL
    verification.
    model/ â€” pure stdlib (math, sys only). Key modelling choices:
    - electrode length (L_el, sets resistance) separated from axial field
    extent (L_drive, sets force); coverage below 100% is a failed gate,
    not a trade-off
    - bubble-coverage correction applied inside the integrator, since theta
    depends nonlinearly on current density
    - operating point found by bisection on V_el(I) = V_rail, not by
    sweeping current
    Buildability gates: coverage, magnet tilability, end-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
2026-10-21 Design: v21-final + v22 specs, v21/v23/v25 CAD artifacts, research notes
2026-10-21 v21 rev: steel clamshell = yoke+structure, potted magnets, printed bellmouth; front-view SVG
2026-10-21 Front-view SVG: material colors (printed=yellow) + legend
2026-10-21 Spec: potting = hot glue or epoxy (no silicone on hand)
2026-10-23 design: v21 fused cube+bellmouth solid (Fusion .f3d + renders)
2026-10-23 design: curved bellmouth (24-section loft) + side flange tabs with 8 M3 holes
2026-10-23 design: full assembly (steel clamshell, magnet trays, liner, electrodes, bellmouth) + printable plastic STLs + laser-cut DXF
2026-10-23 design: v21 assembly complete - 17-body STEP + f3d, printable plastic STLs, laser DXF, 6-page assembly guide
2026-10-23 design: drop stale camera views from the package
2026-10-23 design: exploded assembly (coloured: plastic orange, steel grey, graphite black, magnets red/blue) + segments
2026-10-23 design: clean exploded assembly render (orthographic, nothing clipped); drop the tight Fusion screenshots
2026-10-23 design: v21-r2 - fused tray, pegged cap plates, captive electrode slots, pegged bellmouth+rear block, H 44 mm
2026-10-23 design: v21r2 Fusion files (assembled + exploded, coloured) and labelled STEP
2026-10-23 design: v21-r2 - folded open-ended steel clamshell (flanges bent at split line), laser blank DXF
2026-10-23 design: v21-r2e - uniform 2.5mm folded steel, magnet captive in tray cavity, 3mm electrode seat
2026-10-23 docs: r2e manufacturing + assembly guide, section render, Fusion F3D pair
2026-10-23 release: v21-r2h package - 2 holes per lug, exploded+assembled F3D, STL/DXF, assembly + design docs
2026-10-23 docs: rebuild assembly instructions as a picture-by-picture build manual, 7 step renders from the shipped STEP
2026-10-23 docs: fix step renders (top tray, spread tiles, half-slid electrode) + yoke thickness model
2026-10-24 design: v21-r2i - 3.0 mm yoke, R3 wall folds / R1.5 lug folds, blank 95.57 x 150
2026-10-24 fix: r2i laser blank rebuilt on true bend development (106.43 wide), lug 8->12 for hole edge margin, DXF fully dimensioned
2026-10-24 fix: r2i hole line out of the bend (8.25 from plate face), real R3/R1.5 fillets in the STEP
